GTech9971/cap-locator/Kicad/cap-locator/cap-locator.kicad_pcb

## KiCad design Kicad/cap-locator/cap-locator.kicad_pcb (2025-11-17)

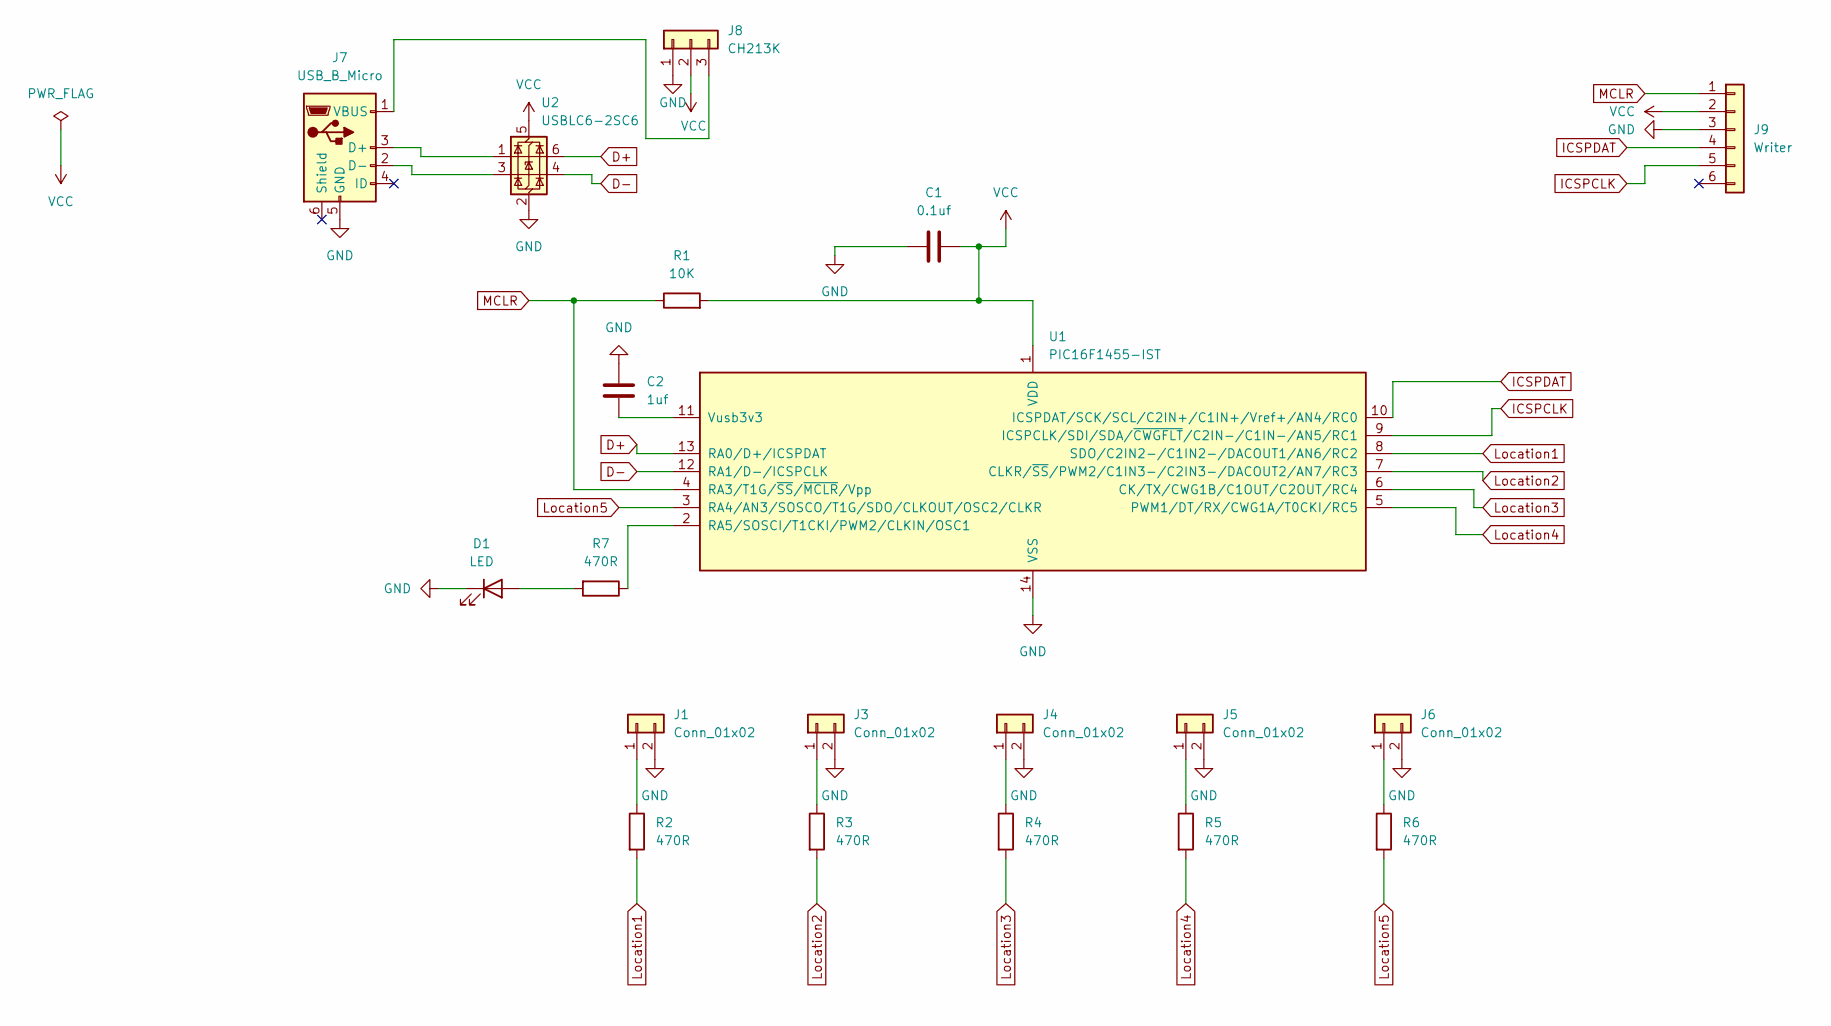
[picture p1: schematic cap-locator.kicad_sch]

Parts:
C1: 0.1uf; C_0603_1608Metric
C2: 1uf; C_0603_1608Metric
D1: LED; LED_0603_1608Metric
J1, J3, J4, J5, J6: Conn_01x02; JST_EH_S2B-EH_1x02_P2.50mm_Horizontal
J7: USB_B_Micro; USB_Micro-B_Molex_47346-0001
J8: CH213K; SOT-23-3
J9: Writer; PinSocket_1x06_P2.00mm_Horizontal
R1: 10K; R_0603_1608Metric
R2, R3, R4, R5, R6, R7: 470R; R_0603_1608Metric
U1: PIC16F1455-IST; TSSOP-14_4.4x5mm_P0.65mm
U2: USBLC6-2SC6; SOT-23-6

Connections:
D+: U1.13 (RA0/D+/ICSPDAT), U2.6 (I/O1)
D-: U1.12 (RA1/D-/ICSPCLK), U2.4 (I/O2)
GND: C1.1, C2.1, D1.1 (K), J1.2, J3.2, J4.2, J5.2, J6.2, J7.5 (GND), J8.1, J9.3, U1.14 (VSS), U2.2 (GND)
ICSPCLK: J9.5, U1.9 (ICSPCLK/SDI/SDA/~CWGFLT/C2IN-/C1IN-/AN5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)
ICSPDAT: J9.4, U1.10 (ICSPDAT/SCK/SCL/C2IN+/C1IN+/Vref+/AN4/R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)
Location1: R2.2, U1.8 (SDO/C2IN2-/C1IN2-/DACOUT1/AN6/RC2)
Location2: R3.2, U1.7 (CLKR/~SS/PWM2/C1IN3-/C2IN3-/DACOUT2/AN7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)
Location3: R4.2, U1.6 (CK/TX/CWG1B/C1OUT/C2OUT/RC4)
Location4: R5.2, U1.5 (PWM1/DT/RX/CWG1A/T0CKI/RC5)
Location5: R6.2, U1.3 (RA4/AN3/SOSCO/T1G/SDO/CLKOUT/OSC2/CLKR)
MCLR: J9.1, R1.1, U1.4 (RA3/T1G/~SS/~MCLR/Vpp)
unnamed: D1.2 (A), R7.2
unnamed: J1.1, R2.1
unnamed: J3.1, R3.1
unnamed: J4.1, R4.1
unnamed: J5.1, R5.1
unnamed: J6.1, R6.1
unnamed: J7.3 (D+), U2.1 (I/O1)
unnamed: J7.2 (D-), U2.3 (I/O2)
unnamed: J7.1 (VBUS), J8.3
unnamed: R7.1, U1.2 (RA5/SOSCI/T1CKI/PWM2/CLKIN/OSC1)
unnamed: C2.2, U1.11 (Vusb3v3)
VCC: C1.2, J8.2, J9.2, R1.2, U1.1 (VDD), U2.5 (VBUS)

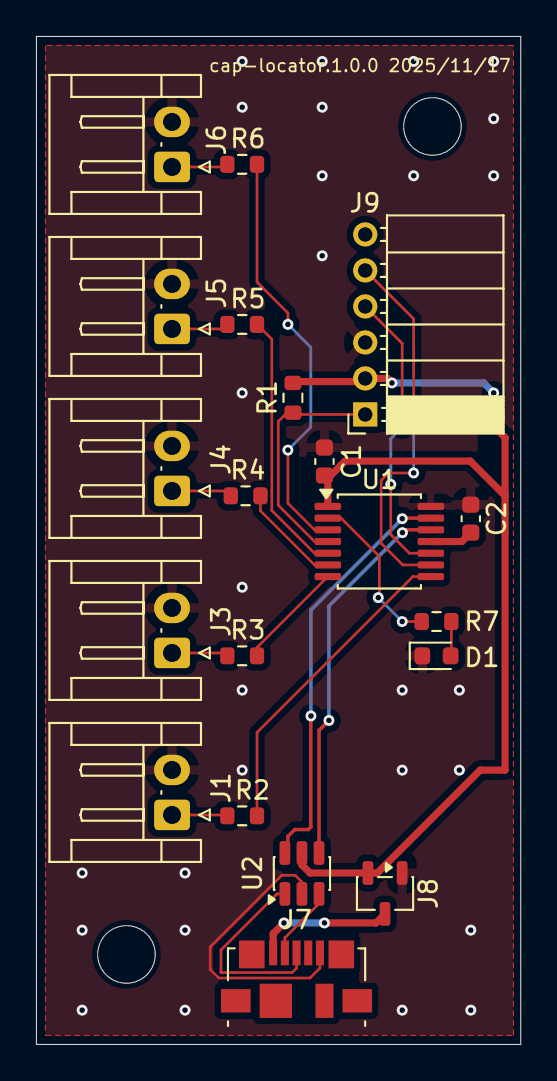
[picture p2: board cap-locator.kicad_pcb from above]

Board: 2 copper layers, 26.9 x 56.0 mm, 22 parts (0 on the bottom side), 23 nets.

Other parts of the board:
MH1, MH2: MountingHole_3.2mm_M3
