GTech9971/cap-locator/(commit log)

2025-11-11 kicadプロジェクト追加
    [cap-locator.kicad_pcb, cap-locator.kicad_sch]
2025-11-11 回路図記載
    [cap-locator.kicad_pcb, cap-locator.kicad_sch]
2025-11-17 基板発注
    [cap-locator-B_Cu.gbl, cap-locator-B_Mask.gbs, cap-locator-B_Silkscreen.gbo, cap-locator-Edge_Cuts.gm1, cap-locator-F_Cu.gtl, cap-locator-F_Mask.gts, cap-locator-F_Silkscreen.gto, cap-locator.drl]
2025-11-30 Update LED pin mapping and Japanese README
2025-12-01 feature report廃止
2025-12-01 feature reportで使用していた不要コード削除
2025-12-05 デバイスにシリアル番号を追記
2025-12-05 バスパワーデバイスに修正
2025-12-30 起動時にステータスLEDが光るようにした
